wmetcalf/voiceover-switch-box/docs/button-card.pdf

# VoiceOver Switch Box

What each control does in VoiceOver mode (the normal mode, for using the iPad).

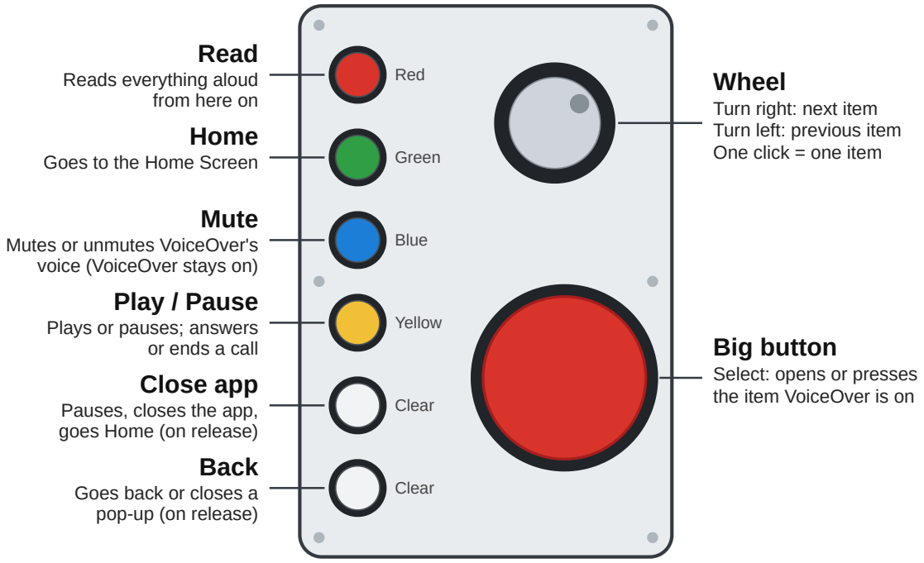
[picture p2: figure]
Read Reads everything aloud from here on; Red; Home; Goes to the Home Screen; Green; Mute Mutes or unmutes VoiceOver's voice (VoiceOver stays on); Blue; Play / Pause Plays or pauses; answers or ends a call; Yellow; Close app Pauses, closes the app, goes Home (on release); Clear; Back Goes back or closes a pop-up (on release); Wheel Turn right: next item Turn left: previous item One click = one item; Big button Select: opens or presses the item VoiceOver is on

Red button lit = box has power. Dark? Flip the USB-C plug at the box.

### Hold two buttons for 3 seconds

Hold
together

Does

Back + Close app (the two clear buttons) | Switches between VoiceOver mode and TD Snap mode. The box gives no sound or light when it switches.

Back +
Green

Turns VoiceOver's Quick Nav on or off. Rarely needed.

### Which mode is it in?

With VoiceOver on, turn the wheel.
VoiceOver moves from item to item = VoiceOver mode.
Nothing happens = TD Snap mode.
The box remembers its mode when unplugged.

### TD Snap mode (scanning)

Control | Does
Wheel, either way | Moves the highlight on
Big button | Chooses the highlighted item
Red | Moves the highlight on
Green | Chooses
Blue | Back
Yellow | iPad Home Screen
Close app (clear) | Next field (Tab)
Back (clear) | Back

If the wheel does nothing with VoiceOver on, the box is probably in TD Snap mode: hold the two clear buttons for 3 seconds. Firmware v10 · github.com/wmetcalf/voiceover-switch-box
