wmetcalf/voiceover-switch-box/hardware/pcb/voiceover_pcb_bom.csv

Qty | Refs | Value | Footprint
1 | BZ1 | Magnetic buzzer 3V, ~2.7kHz (or passive piezo) | Buzzer_Beeper:Buzzer_12x9.5RM7.6
2 | C1 C5 | 100nF | Capacitor_SMD:C_0805_2012Metric
1 | C2 | 10uF | Capacitor_SMD:C_0805_2012Metric
2 | C3 C4 | 4.7uF | Capacitor_SMD:C_0805_2012Metric
1 | D1 | 1N4148W | Diode_SMD:D_SOD-323
1 | D2 | B5819W | Diode_SMD:D_SOD-123
1 | D3 | Red - charging | LED_SMD:LED_0805_2012Metric
4 | H1 H2 H3 H4 | M3 | MountingHole:MountingHole_3.2mm_M3
1 | J1 | Pico 2 W pins 1-20 | Connector_PinSocket_2.54mm:PinSocket_1x20_P2.54mm_Vertical
1 | J2 | Pico 2 W pins 21-40 | Connector_PinSocket_2.54mm:PinSocket_1x20_P2.54mm_Vertical
1 | J3 | BTN Select 100mm | Connector_JST:JST_XH_B2B-XH-A_1x02_P2.50mm_Vertical
1 | J4 | BTN Red | Connector_JST:JST_XH_B2B-XH-A_1x02_P2.50mm_Vertical
1 | J5 | BTN Green | Connector_JST:JST_XH_B2B-XH-A_1x02_P2.50mm_Vertical
1 | J6 | BTN Blue | Connector_JST:JST_XH_B2B-XH-A_1x02_P2.50mm_Vertical
1 | J7 | BTN Yellow | Connector_JST:JST_XH_B2B-XH-A_1x02_P2.50mm_Vertical
1 | J8 | BTN Chooser | Connector_JST:JST_XH_B2B-XH-A_1x02_P2.50mm_Vertical
1 | J9 | BTN Back/Escape | Connector_JST:JST_XH_B2B-XH-A_1x02_P2.50mm_Vertical
1 | J10 | Encoder | Connector_JST:JST_XH_B4B-XH-A_1x04_P2.50mm_Vertical
1 | J11 | LiPo 1S (JST-PH) — check polarity! | Connector_JST:JST_PH_B2B-PH-K_1x02_P2.00mm_Vertical
1 | J12 | Power switch (panel SPST) | Connector_JST:JST_XH_B2B-XH-A_1x02_P2.50mm_Vertical
1 | J13 | RESET | Connector_PinHeader_2.54mm:PinHeader_1x02_P2.54mm_Vertical
1 | J14 | Red button LED (power light): 1 = LED + (VBUS), 2 = LED - (GND) | Connector_JST:JST_XH_B2B-XH-A_1x02_P2.50mm_Vertical
1 | JP1 | ENC VCC: A=3V3 (default) / B=VSYS | Jumper:SolderJumper-3_P1.3mm_Open_RoundedPad1.0x1.5mm
1 | Q1 | MMBT3904 | Package_TO_SOT_SMD:SOT-23
4 | R1 R3 R5 R8 | 1k | Resistor_SMD:R_0805_2012Metric
2 | R2 R4 | 2k DNP (fit only if ENC VCC=VSYS) | Resistor_SMD:R_0805_2012Metric
3 | R6 R9 R10 | 100k | Resistor_SMD:R_0805_2012Metric
1 | R7 | 4.7k (~210mA charge) | Resistor_SMD:R_0805_2012Metric
1 | U1 | MCP73831T-2ACI/OT | Package_TO_SOT_SMD:SOT-23-5
