wmetcalf/voiceover-switch-box/docs/build-guide.html

VoiceOver + TD Snap Adaptive Device

Complete Build Guide v10.11 — Dual-Mode · Raspberry Pi Pico 2 WH

🖶 PRINT WHOLE GUIDE

Prints every tab except the stencils, which have their own print buttons. Nothing happens? Open this page in Safari or Chrome.

① PARTS ② HOW IT WORKS ③ WIRING ③b PHYSICAL ③c WIRE STEPS ④ BUILD ⑤ FIRMWARE ⑥ iPHONE/iPAD ⑥b TD SNAP ⑦ LID STENCIL ⑦b SIDE STENCIL ⑧ PCB ⑨ TROUBLESHOOT

1Complete Parts List

01 — BRAIN

Raspberry Pi Pico 2 WH

Amazon B0DPF9N1MN (https://www.amazon.com/dp/B0DPF9N1MN)

~$10

02 — WHEEL

Adafruit 60mm CNC Rotary Encoder

adafruit.com — #5734

~$25

03 — SELECT BUTTON

Adafruit 100mm Arcade Button

adafruit.com — #1185 red or #1187 white

~$10

04 — RED MACRO

Adafruit 30mm LED Button — Red

adafruit.com — #3489

~$3

05 — GREEN MACRO

Adafruit 30mm LED Button — Green

adafruit.com — #3487

~$3

06 — BLUE MACRO

Adafruit 30mm LED Button — Blue

adafruit.com — #3490

~$3

07 — YELLOW MACRO

Adafruit 30mm LED Button — Yellow

adafruit.com — #3488

~$3

08 — CHOOSER + BACK

Adafruit 30mm LED Button — Clear ×2

adafruit.com — #3491

~$6

09 — SELECT WIRES

Quick-Connect Wires 0.187" (10-pack)

adafruit.com — #3835

~$5

10 — MACRO WIRES

Quick-Connect Wire Pairs 0.11" (10-pack)

adafruit.com — #1152 · 7 pairs used; a second pack if you light every button

~$5

11 — JUMPERS

ELEGOO Jumper Wire Kit (M-M and F-M)

Amazon B01EV70C78 (https://www.amazon.com/dp/B01EV70C78) (120-piece)

~$7

12 — BREADBOARD

400-Point Solderless Breadboard

Amazon B08Y59P6D1 (https://www.amazon.com/dp/B08Y59P6D1) (BOJACK kit, 830 + 400 point)

~$4

13 — BOX

LeMotech 263×182×95mm IP65 ABS Box (pale gray)

Amazon B0785ZBNKK (https://www.amazon.com/dp/B0785ZBNKK)

~$18

14 — HOLE SAW

HYCHIKA 19pc Hole Saw Kit, 19–152mm

Amazon B07Y1G2Y7K (https://www.amazon.com/dp/B07Y1G2Y7K) · the original box used its 44, 32 and 28mm saws; 22mm (filed out to 24) suits the USB-C port

~$20

15 — iPAD CABLE

USB-C to USB-C cable that carries data (USB-C iPads, iPhone 15+)

Lightning devices: Apple Lightning to USB Camera Adapter + USB-A to USB-C cable

~$6

16 — USB-C PANEL MOUNT

PENGLIN USB-C female-to-female panel-mount coupler, D-type (2-pack)

Amazon B0B4VWZD7X (https://www.amazon.com/dp/B0B4VWZD7X) · 24 mm hole, 2 screws; one spare. Passes power one way round only

~$8

17 — INTERNAL CABLE

Cable Matters braided USB-C to micro-USB cable, 1 m

Amazon B00UUBRX0Y (https://www.amazon.com/dp/B00UUBRX0Y) · panel mount → Pico, inside the box

owned

18 — SOLDER BOARD (optional)

Adafruit Perma-Proto half-size (#1609)

Same layout as the breadboard, soldered — see PCB tab

~$5

ESTIMATED TOTAL

~$143

!The Big Picture — What This Device Does

This device plugs into the iPad’s USB-C port (or pairs over Bluetooth). Once plugged in, it acts like a keyboard the iPad understands. When you turn the wheel or press a button, the device sends a keyboard signal to the iPhone/iPad telling VoiceOver (or TD Snap) what to do — exactly like if someone were swiping or tapping on the screen, but without needing fine motor control.

🎛

Wheel or Button

Student turns wheel or presses button

→

🟢

Pico (Brain)

Tiny computer converts it to a keyboard signal

→

📱

iPad

VoiceOver moves or activates

!What Each Control Does

The device has two modes. VoiceOver mode drives the iPhone/iPad screen reader. TD Snap mode drives the TD Snap communication app’s scanning. To switch, hold Back and Chooser together for 3 seconds (one button held alone never switches); the device remembers the mode after power-off. Back and Chooser act when released, so starting the two-button hold sends nothing.

Control | VoiceOver mode | Sends | TD Snap mode | Sends
Wheel, clockwise | Next item | VO + → | Advance scan | Space
Wheel, counter-clockwise | Previous item | VO + ← | Advance scan | Space
Big Select | Activate (= double-tap) | VO + Space | Select highlighted | Enter
● Red | Read from here | VO + A | Advance scan (spare) | Space
● Green | Home screen | VO + H | Select (spare) | Enter
● Blue | Mute / unmute VoiceOver speech (VoiceOver stays on) | VO + S | Back | Escape
● Yellow | Magic Tap (play/pause, answer/end call) | VO + Hyphen | iPad Home | Cmd + H
Chooser | Close the current app (on release): pause media, close the app, then Home | Media Pause · Cmd+W · Cmd+H | Next field | Tab
Back | Back / dismiss (on release) | Escape | Back | Escape
Back + Chooser — hold both 3 s | Switch to TD Snap mode | — | Switch to VoiceOver mode | —
Back + Green — hold both 3 s | Turn VoiceOver Quick Nav on/off (Green goes Home first) | ← + → together | Nothing extra (Green still selects) | —

VO = Control + Option.

How the device tells you what it’s doing:

- Power light: the Red button glows whenever the box has power. Dark when plugged in = flip the USB-C plug at the box end (the port only passes power one way round), or try another cable.
- Which mode? With VoiceOver on, turn the wheel. Moving from item to item = VoiceOver mode. Nothing happens = TD Snap mode.
- Mode switch (hold Back + Chooser together 3 s): the box gives no sound or light outside, so check with the wheel afterwards
- Pico’s LED (inside the box): on 1 s / off 1 s = VoiceOver, on ½ s / off ½ s = TD Snap, lit during every keystroke

!How to Read the Wiring Diagram

The wiring diagram in the WIRING tab looks technical, but it's really just a map showing where each wire plugs in. You don't need to understand electronics to use it — just match the wire colors and follow the labels.

The Yellow/Brown Board

This is the breadboard — a plastic block with holes in it. Wires just push into the holes. No tools, no glue. It's just a holder that keeps everything connected. You can pull wires out and move them if you make a mistake.

The Green Rectangle

This is the Pico — the tiny computer that runs everything. It sits on the breadboard. Inside the box a short cable runs from the Pico to the USB-C port on the side; the iPad’s cable plugs in there. That one cable also powers the device.

Row Numbers (1–30)

The holes on the breadboard are numbered 1–30 down the side. When a wire says "row 14", count down to hole number 14 from the top. Each row connects horizontally — so a wire in row 14 col A is connected to row 14 col B, C, D, E automatically inside the board.

Column Letters (a–j)

Each row has 10 holes labeled a through j across the top. The gap in the middle separates the two halves. The left half (a–e) is where the left side of the Pico sits. The right half (f–j) is where the right side sits.

The Red/Blue Strips (+ and −)

The red strip (+) carries 3.3V power. The blue strip (−) is ground. Think of them like the positive and negative of a battery. The encoder wheel needs both of these to power itself. All the button grounds connect to the blue (−) strip.

The Colored Lines

Each colored line is one wire. The color just helps you tell them apart — red means power, black means ground, yellow means encoder signal, purple means select button, and so on. The line shows where each end of the wire goes.

The most important rule: Each wire has two ends. One end goes to a Pico pin (shown in the diagram by the row and column). The other end goes to the button or encoder terminal. As long as both ends are in the right place, it works.

!What Each Wire Color Means

#### Red wire

Power (3.3V). Goes from the Pico's power pin to the encoder wheel's power terminal. The encoder needs this to work.

#### Black wire

Ground. Every component needs a ground wire to complete the circuit. Think of it as the return path for electricity.

#### Yellow wire (×2)

Encoder signals. These two wires tell the Pico which direction the wheel is turning and how fast. One wire = clockwise/counterclockwise, the other = how far.

#### Purple wire

Select button signal. When the big button is pressed, this wire carries a tiny signal to the Pico saying "activate now".

#### Red wire (macro)

Red button signal. Separate from the power red wire — this one connects the red macro button to the Pico.

#### Green wire

Green button signal. Connects the green macro button to the Pico.

#### Blue wire

Blue button signal. Connects the blue macro button to the Pico.

#### Yellow wire (macro)

Yellow button signal. Connects the yellow macro button to the Pico.

#### White wires (×2)

Chooser and Back button signals (the two clear buttons). Back’s is drawn dashed.

#### Pink-red wire

5 V from VBUS to the Red button’s light, the power indicator. Not 3.3 V.

3Breadboard Wiring Diagram

Encoder A/B (GP10/11)

Select (GP15)

Red (GP16) / 3.3V

Green (GP17)

Blue (GP18)

Yellow (GP19)

Chooser / Back (GP20/21)

Red LED power light (VBUS 5 V)

GND

!Complete Wire Reference

COLOR | FROM (Pico pin) | TO | CONNECTOR
Red | 3.3V — right + rail | Encoder VCC screw terminal | M-M jumper
Black | GND — left − rail | Encoder GND screw terminal | M-M jumper
Yellow | GP10 — left col e, row 14 | Encoder A screw terminal | M-M jumper
Yellow (dashed) | GP11 — left col e, row 15 | Encoder B screw terminal | M-M jumper
Purple | GP15 — left col e, row 20 | Select button terminal 1 | M-M + 0.187" pair
Black | GND rail, any row | Select button terminal 2 | M-M + 0.187" pair
Red | GP16 — right col f, row 20 | Red button signal | M-M + 0.11" pair
Green | GP17 — right col f, row 19 | Green button signal | M-M + 0.11" pair
Blue | GP18 — right col f, row 17 | Blue button signal | M-M + 0.11" pair
Yellow | GP19 — right col f, row 16 | Yellow button signal | M-M + 0.11" pair
White | GP20 — right col f, row 15 | Chooser (clear) button signal | M-M + 0.11" pair
White (dashed) | GP21 — right col f, row 14 | Back (clear) button signal | M-M + 0.11" pair
Black ×6 | GND rail, any row | Each 30 mm button GND terminal | M-M + 0.11" pair
Pink-red | VBUS (5 V) — right side, row 1 | Red button LED + tab (power light) | M-M + 0.11" pair
Black | GND rail, any row | Red button LED − tab | M-M + 0.11" pair
USB cable | Pico micro-USB | USB-C panel port on the box, then iPad | Internal USB-C to micro-USB cable

Button wires: each Adafruit quick-connect pair has two spade clips joined in a 2-pin plug. Push the clips onto the button’s two terminals and two M-M jumpers into the plug, one to the signal row and one to the − rail. All button GND wires and the Red LED − tap off the minus rails. The Red LED + goes to VBUS (row 1 right, 5 V), never the + rail: the button LEDs need 5 V. A bridge wire at row 28 connects left and right minus rails so GND is available on both sides.

!Physical Wiring Reference

Pico 2 WH on 400-point breadboard. USB port faces UP toward row 1. Left pins in col e, right pins in col f. 4 free columns on each side (a-d left, g-j right).

Pin / Row | GPIO | Connects to | Wire
Row 3 right | GND | Right − rail | Short black M-M
Row 5 right | 3V3 | Right + rail | Short red M-M
− rail bridge | — | Left − → Right − | Long black M-M (row 28)
Right + rail | — | Encoder VCC screw terminal | Red M-M jumper
Left − rail | — | Encoder GND screw terminal | Black M-M jumper
Row 14 left | GP10 | Encoder A screw terminal | Yellow M-M
Row 15 left | GP11 | Encoder B screw terminal | Yellow M-M
Row 20 left | GP15 | Select button signal | Purple + 0.187" pair
Left − rail | — | Select button GND | Black + 0.187" pair
Macro buttons (right side, 0.11" pairs) — skip row 18!
Row 20 right | GP16 | ⬤ Red button signal | Red M-M + 0.11" pair
Row 19 right | GP17 | ⬤ Green button signal | Green M-M + 0.11" pair
Row 17 right | GP18 | ⬤ Blue button signal | Blue M-M + 0.11" pair
Row 16 right | GP19 | ⬤ Yellow button signal | Yellow M-M + 0.11" pair
Row 15 right | GP20 | Chooser button signal | M-M + 0.11" pair
Row 14 right | GP21 | Back button signal (hold with Chooser 3 s = switch mode) | M-M + 0.11" pair
v10 additions
Row 1 right | VBUS | Red button LED + (power light). LED − → − rail | 0.11" quick-connect; 5 V, never the + rail
Left − rail ×6 | — | Each macro button GND | 6× black + 0.11" pair

Row 18 right = GND — skip it! Jump from row 19 (Green) directly to row 17 (Blue). No wire for row 18.

Encoder terminals: loosen each screw, insert a jumper’s pin, tighten. Go by the labels printed beside the terminals (VCC or +, GND or 0V, A, B); leave any others unused.

!Step-by-Step Wiring — One Wire at a Time

14 steps with diagrams. Each step shows exactly which row and column.

Step 1 of 140%

← Back Next →

4Physical Construction

1

### Print the drill stencil

Go to the LID STENCIL tab and click PRINT THIS STENCIL. Letter or A4, Landscape, scale 100% — do NOT fit to page. Verify the 100mm scale bar measures exactly 100mm with a ruler before drilling.

2

### Tape stencil and center punch

Cut along dashed border and tape firmly to the box lid. Tap a nail or center punch on each crosshair mark to make a small dent — stops the drill from walking.

3

### Drill the holes

- Encoder center — 44mm (the kit’s 1¾" saw)
- Encoder M3 screws (×3) — 3.5mm drill bit
- Select button — 28mm (the kit’s 1⅛" saw; the 24mm thread goes through and the dome covers the hole)
- 6× 30mm buttons — 32mm (the kit’s 1¼" saw). Adafruit asks for about 30mm; 32mm is what the original box used, and the flange still covers it.
- USB-C panel mount (side panel) — 24mm: the kit’s 22mm saw, then file out to fit (or a step drill), + 3.5mm drill bit (×2 flange screws). Don’t go bigger: the flange is only a little wider.

Pilot holes: Drill a 6–8mm pilot through every hole saw center mark first — stops the saw from wandering and prevents cracking the ABS. Use the crosshair on the stencil. Go slow — ABS melts if you push hard. Deburr edges after.

Clamp the lid before drilling. ABS grabs the bit at breakthrough.

4

### Mount USB-C panel connector on side panel

Print the SIDE STENCIL: centered on the 182 mm face, 20 mm from the bottom. Cut the 24 mm hole, then hold the D-type coupler in place and drill a 3.5 mm hole through each of its two flange holes (they sit on opposite corners). Plug the USB-C end of the internal cable into the coupler’s inside socket and the micro-USB end into the Pico.

5

### Mount encoder wheel

Drop it into the hole from above, face on the lid. Fix it with three M3 screws through the holes you marked (nuts underneath if its holes aren’t threaded). Connect M-M jumper wires by inserting a pin into each screw terminal and tightening the screw.

6

### Mount 100mm select button

Insert from above, tighten ring from below. Clip 0.187" quick-connect wires onto the two spade terminals on the internal microswitch.

7

### Mount the six 30mm buttons in a row

Insert each 30mm button, tighten ring from below. Clip 0.11" wires onto the switch terminals, and onto the Red button’s two LED tabs (the power light). With the box standing upright the row becomes the left-hand column, Red at the top.

Order: Red (GP16) · Green (GP17) · Blue (GP18) · Yellow (GP19) · Chooser (GP20, clear) · Back (GP21, clear)

8

### Wire the breadboard

Pico on breadboard straddling center gap, USB port facing out. Wire all connections per the WIRING tab.

9

### TEST before closing the box

Plug the iPad in and test the wheel, the select button and all six buttons. The Red button should light. Fix issues now while the lid is off.

Everything working? Close the box.

Do not close until all buttons work.

10

### Close and finish

Tighten the lid screws. Add rubber feet to bottom corners.

6iPhone / iPad Setup — VoiceOver Mode

Do this once on the student’s iPad. Using the TD Snap app? Do this tab first (the student still needs VoiceOver to get around), then the TD SNAP tab.

Cable: the box has a USB-C port. USB-C iPads and iPhone 15 and later → a USB-C to USB-C cable that carries data (many are charge-only). iPhone 14 and earlier → Apple’s Lightning to USB Camera Adapter plus a USB-A to USB-C cable. Not needed for Bluetooth.
One way round: the box’s USB-C port only passes power with the plug one way up. The Red button lights when it’s right. Best: leave the cable plugged into the box and unplug it only at the iPad, whose port works either way.

1

### Turn on VoiceOver and set the triple-click shortcut

Settings → Accessibility → VoiceOver → ON, then Settings → Accessibility → Accessibility Shortcut → VoiceOver.

The box can’t turn VoiceOver off, so a blind user can’t strand themselves. A caregiver toggles it by triple-clicking the side or top button.

2

### Check VoiceOver’s modifier keys

Settings → Accessibility → VoiceOver → Typing → Modifier Keys must include Control + Option. Every VoiceOver command from the box uses it.

3

### Turn OFF Full Keyboard Access

Settings → Accessibility → Keyboards & Typing → Full Keyboard Access → OFF

If it’s on, it grabs the keystrokes before VoiceOver sees them and the buttons appear dead.

4

### Connect the device

- Allow the accessory. On iPadOS 26: Settings → Privacy & Security → Wired Accessories → Always Allow or Automatically Allow When Unlocked. If the iPad was locked when the box was plugged in, unplug it, unlock the iPad, and plug it in again.
- USB: plug it in. The Red button lights when the box has power; if it stays dark, flip the plug at the box end. If iOS says the accessory needs keyboard setup, tap Dismiss.
- Keyboard layout: U.S. Settings → General → Keyboard → Hardware Keyboard. Other layouts move the letter keys the box relies on.
- Bluetooth (optional): power the device, then Settings → Bluetooth and tap VoiceOver Device. One-time pairing. When USB is plugged in, the box sends over USB only, so nothing is typed twice.

5

### Turn off the things that surprise the student

- Picture in Picture: Settings → General → Picture in Picture → Start PiP Automatically → OFF. Otherwise, going Home from Netflix or Apple TV during a video keeps it playing in a floating window.
- Dictation shortcut: if Settings → General → Keyboard offers a “press Control twice” Dictation shortcut, turn it off. Current firmware avoids triggering it, but there’s no reason to leave it on.
- Home Screen: keep the student’s apps on the first page or in the dock. The box has no button for changing pages; pressing Green (Home) again on the Home Screen goes back to the first page.
- Notifications: turn on a Focus / Do Not Disturb mode during games and videos so alerts don’t interrupt.

6

### Check the mode

With VoiceOver on, turn the wheel. If VoiceOver moves from item to item, the box is in VoiceOver mode. If nothing happens it is in TD Snap mode — hold Back and Chooser together for 3 seconds to switch. (With the lid off, the Pico’s LED also shows it: on 1 s / off 1 s = VoiceOver, twice as fast = TD Snap.)

7

### Quick Nav doesn’t matter

The box sends Control + Option commands, which work whether Quick Nav is on or off. If you want to change it anyway, hold Back and Green together for 3 seconds; VoiceOver says “Quick Nav on” or “off”.

8

### Watching games and videos

- Blue mutes VoiceOver; press it again to bring the voice back. VoiceOver stays on, so the student can unmute it themselves.
- While muted, the wheel still moves VoiceOver’s focus silently — unmute before navigating.
- Yellow plays or pauses. Chooser pauses, closes the app and goes Home.

9

### Try it

Turn the wheel — VoiceOver should speak each item. Press the big button to open it.

Control | Does | Sends
Wheel, clockwise | Next item | VO + →
Wheel, counter-clockwise | Previous item | VO + ←
Big Select | Activate (= double-tap) | VO + Space
● Red | Read from here | VO + A
● Green | Home screen | VO + H
● Blue | Mute / unmute VoiceOver speech (VoiceOver stays on) | VO + S
● Yellow | Magic Tap (play/pause, answer/end call) | VO + Hyphen
Chooser | Close the current app (on release): pause media, close the app, then Home | Media Pause · Cmd+W · Cmd+H
Back | Back / dismiss (on release) | Escape
Back + Chooser — hold both 3 s | Switch to TD Snap mode | —
Back + Green — hold both 3 s | Turn VoiceOver Quick Nav on/off (Green goes Home first) | ← + → together

6bTD Snap Mode — iPad Setup

TD Snap (Tobii Dynavox) is an AAC app: the student picks words and phrases and TD Snap speaks them. Its own scanning access method moves a highlight across the buttons; it takes Space as “move the highlight” and Enter as “choose this”. In TD Snap mode the device sends exactly those keys.

For a student who is blind and non-speaking, VoiceOver gets them around the iPad and into TD Snap; TD Snap’s Audio Feedback (step 3) tells them what the scan highlight is on. Both matter.

1

### Switch the device to TD Snap mode

Hold Back and Chooser together for 3 seconds. The box gives no sound or light when it switches. The mode is remembered after power-off. Do the same again to return to VoiceOver mode.

Switch back to VoiceOver mode before using VoiceOver. In TD Snap mode the wheel sends Space, which VoiceOver ignores, so the box looks broken: the wheel does nothing and only Chooser (Tab) seems to work.

2

### Configure TD Snap scanning

In TD Snap, open Edit, then User → Access Method:

1. Access Method: Scanning
2. Scan Type: 2 Switch Step Scan
3. Switch 1 (Next): Space · Switch 2 (Select): Enter
4. Tap Done

Don’t use 1 Switch Auto Scan with Enter as the switch — Tobii Dynavox documents that it stops responding after you leave the app. The device is built for 2 Switch Step Scan.

The Scanning page set is organised for efficient scanning; other page sets work but scan more slowly.

3

### Turn on Audio Feedback — essential for this student

Same screen (User → Access Method): Audio Feedback → ON. Pick a voice that is different from the student’s speaking voice, so they can tell “what the highlight is on” from “what I’m saying”.

If the student has some vision, also try Zoom and a high-contrast highlight.

4

### VoiceOver and TD Snap together — test this first

Not yet verified: whether TD Snap still receives Space/Enter while VoiceOver is on. Test it:

1. VoiceOver on. Open TD Snap. Put the device in TD Snap mode.
2. Turn the wheel one click.
3. Highlight moves and Audio Feedback speaks → leave VoiceOver on. Simplest setup.
4. Nothing happens, or VoiceOver talks over it → a caregiver triple-clicks to turn VoiceOver off while in TD Snap, and back on when leaving.

Either way: Full Keyboard Access and Switch Control stay OFF.

5

### Button map in TD Snap mode

Control | Does | Sends
Wheel, clockwise | Advance scan | Space
Wheel, counter-clockwise | Advance scan | Space
Big Select | Select highlighted | Enter
● Red | Advance scan (spare) | Space
● Green | Select (spare) | Enter
● Blue | Back | Escape
● Yellow | iPad Home | Cmd + H
Chooser | Next field | Tab
Back | Back | Escape
Back + Chooser — hold both 3 s | Switch to VoiceOver mode | —
Back + Green — hold both 3 s | Nothing extra (Green still selects) | —

6

### Guided Access — probably not for this student

Guided Access locks the iPad to TD Snap. That blocks the student from leaving TD Snap to use VoiceOver elsewhere, so only use it for sessions where TD Snap is the only activity: Settings → Accessibility → Guided Access, set a passcode, open TD Snap, triple-click, Start.

!Firmware — v10.11

v10 changes: VoiceOver commands no longer depend on Quick Nav · USB or Bluetooth, never both · encoder read by interrupt, one step per click · debounce plus adjustable hold time and ignore-repeat · two-button mode switch · Red no longer turns VoiceOver off; Blue mutes/unmutes VoiceOver (v10.1) · wheel stops when the hand stops (v10.2) · USB never freezes, wakes a sleeping iPad, reboots itself if it ever hangs (v10.3) · mode switch needs Back + Chooser held together, so one long press can’t change modes; USB serial test port (v10.4) · key combinations typed like a person, timed from when the iPad picks them up, so iPad VoiceOver accepts them (v10.5) · fast wheel spins no longer open Dictation (v10.6) · Chooser changes Home Screen page: press = next, hold 1 s = previous (v10.7) · Back + Green held 3 s toggles VoiceOver Quick Nav (v10.8) · Chooser closes the current app instead of turning pages (v10.9); pauses video first so it doesn’t go to Picture in Picture (v10.10) · optional battery monitor. Compiles cleanly against arduino-pico 6.3.0 (Pico 2 W, IPv4 + Bluetooth) and passes 44 simulated scenarios (wheel, buttons, debounce, two-button mode switch, key-combination timing including a slow-polling iPad, Control never pressed alone, USB/Bluetooth routing, USB stall and sleep, watchdog, serial test port).

⚡

### Quickest: install the ready-made firmware (no Arduino needed)

This installs firmware v10.11 with the default settings. Use the Arduino steps below only if you need to change settings.

⬇ DOWNLOAD voiceover_device_ble.uf2

1. Unplug the Pico. Hold its white BOOTSEL button, plug the USB cable into the computer, then let go.
2. A drive named RP2350 appears.
3. Drag voiceover_device_ble.uf2 onto it. The drive disappears and the Pico restarts (its LED flashes 3 times).

Mac: a “Disk Not Ejected Properly” message afterwards is normal. If Finder refuses the copy, use Terminal: cp -X ~/Downloads/voiceover_device_ble.uf2 /Volumes/RP2350/ (or rsync ~/Downloads/voiceover_device_ble.uf2 /Volumes/RP2350/).

Windows: drag it onto the RP2350 drive in File Explorer.

A

### Install Arduino IDE

Download Arduino IDE 2 from arduino.cc. Mac: drag it into Applications. Windows: use the EXE installer, not the Microsoft Store version (it has USB detection issues).

B

### Add the Earle Philhower board package

File → Preferences → Additional Board Manager URLs → add:

https://github.com/earlephilhower/arduino-pico/releases/download/global/package_rp2040_index.json

Then Tools → Board → Boards Manager → search pico → install Raspberry Pi Pico/RP2040/RP2350 by Earle F. Philhower III.

C

### Select the correct board

Tools → Board → Raspberry Pi RP2040/RP2350 → Raspberry Pi Pico 2 W

D

### Enable Bluetooth — CRITICAL

Tools → IP/Bluetooth Stack → IPv4 + Bluetooth. Leave Tools → USB Stack on Pico SDK.

Nothing will work without this. The Bluetooth libraries won’t compile unless this is set.

E

### Download and upload the sketch

Click the download button below to get the .ino file. Open it in Arduino IDE. Then:

1. Hold BOOTSEL button on the Pico
2. Plug USB into your PC while holding BOOTSEL
3. Release BOOTSEL — a drive called RP2350 appears
4. Click Upload in Arduino IDE
5. Wait ~30 seconds for "Done uploading"
6. Later updates don’t need BOOTSEL: pick the Pico’s port and click Upload. The box’s USB-C port works for this too (right way up).

LED flashes 3 times — firmware is running in VoiceOver mode.

F

### Tuning for the student

All settings are at the top of the sketch. Change, re-upload.

- COUNTS_PER_STEP — 4 = one step per wheel click, 8 = one step per two clicks.
- HOLD_MS — a press must last this long to count. Filters brushes and tremor. Try 100–300.
- IGNORE_REPEAT_MS — ignores a second press of the same button within this window. Filters double-hits. Try 300–800.
- MODE_HOLD_MS — how long to hold Back + Chooser together to switch modes (default 3000).
- ENC_MAX_PENDING — how many wheel steps can queue up when the wheel is spun fast (default 3). Lower = stops sooner.
- ENC_REVERSE, BATT_SENSE_ENABLED (PCB with battery only).

Set these with the student’s OT — they’re the same ideas as iOS Switch Control’s Hold Duration and Ignore Repeat.

G

### Bluetooth name

The sketch passes the name to KeyboardBLE.begin("VoiceOver Device"). The library only falls back to “PicoW BLE Keyboard” when no name is passed, so no library patch is needed — the v8/v9 patcher script was unnecessary.

If the iPad still shows the old name, iOS is showing a cached name for this device. On the iPad: Settings → Bluetooth → (i) → Forget This Device, turn Bluetooth off, power-cycle the device, turn Bluetooth on, pair again.

To see what the device is actually advertising, scan with the free nRF Connect app on a phone that has never paired with it.

⬇ DOWNLOAD voiceover_device_ble.ino

/*
 * ═══════════════════════════════════════════════════════════════════
 * VoiceOver + TD Snap Adaptive Device — firmware v10.11
 * Raspberry Pi Pico 2 W · Earle Philhower arduino-pico core
 *
 *   Board: Raspberry Pi Pico 2 W
 *   Tools > IP/Bluetooth Stack > IPv4 + Bluetooth      <- REQUIRED
 *   Tools > USB Stack > Pico SDK (the default)
 *
 * Changes from v9
 *   • VoiceOver mode sends VO-prefixed commands (Ctrl+Option+…), so it
 *     works whether Quick Nav is on or off. Quick Nav no longer matters.
 *   • Keys go to USB when a host is connected, otherwise to BLE —
 *     never both (v9 double-typed when USB and BLE hit the same iPad).
 *   • Encoder decoded by interrupt (x4); key output is non-blocking, so
 *     fast wheel turns no longer drop pulses.
 *   • One wheel click = one step (v9 stepped every 1.5 clicks).
 *   • Debounce on every input, plus optional hold time / ignore-repeat
 *     for users with tremor.
 *   • Audio feedback through an optional piezo (silent if not fitted).
 *   • Mode switch: hold BACK + CHOOSER together for 3 s (v10.4; was BACK
 *     alone, which was too easy to trigger by accident). No re-plugging.
 *   • Red no longer turns VoiceOver off (a stranding risk for a blind user).
 *   • v10.1: Blue mutes/unmutes VoiceOver speech (VO+S) so it stays quiet
 *     during videos and games; VoiceOver stays on, the same button brings it back.
 *   • v10.2: wheel steps no longer pile up when spun fast. At most
 *     ENC_MAX_PENDING steps are buffered, and turning back cancels pending
 *     forward steps (VoiceOver mode), so the focus stops when the hand stops.
 *   • v10.3: USB never freezes the firmware. If the host is connected but
 *     not reading the keyboard, keys go over Bluetooth after 50 ms instead
 *     of stalling ~2 s per press. A sleeping host gets a USB wake-up request.
 *     8 s watchdog: if anything ever hangs, the device reboots itself.
 *   • v10.4: mode switch needs BACK + CHOOSER held together for 3 s, so a long
 *     press on one button can't silently change modes. BACK and CHOOSER now act
 *     on release (so starting the two-button hold sends nothing). USB serial
 *     test port: a computer can press buttons and read status (see SERIAL TEST).
 *   • v10.5: key combinations are typed like a person types them: Control +
 *     Option go down 40 ms before the key, the key is held 60 ms, and the
 *     modifiers come up after the key (v10.4 sent them all within a few ms).
 *     Hold times now start when the host has taken each report, so an iPad
 *     that polls slowly still sees the full 60 ms (it measured 1-3 ms on v10.4).
 *   • v10.6: spinning the wheel fast no longer opens Dictation on the iPad.
 *     Option goes down before Control, so Control is never pressed alone, and
 *     Control+Option stay held through a fast spin instead of tapping per step.
 *   • v10.7: in VoiceOver mode CHOOSER changes Home Screen page instead of
 *     opening the item chooser: press = next page (Option+→), hold 1 s =
 *     previous page (Option+←, a tick sounds at 1 s). Needs VoiceOver Quick
 *     Nav on (the iPad default). TD Snap mode is unchanged (Tab).
 *   • v10.8: hold BACK + GREEN for 3 s to toggle VoiceOver Quick Nav (sends
 *     Left + Right arrow together; VoiceOver says "Quick Nav on/off"). Chooser's
 *     page turning only works with Quick Nav on.
 *   • v10.9: in VoiceOver mode CHOOSER closes the current app: Home, then
 *     Cmd+Tab / Cmd+Q in the app switcher, Cmd+Esc, Home (replaces the v10.7
 *     page turning). TD Snap mode is unchanged (Tab).
 *   • v10.10: CHOOSER close-app sends media Pause first, then Cmd+W, then Home,
 *     so a playing video isn't pushed into Picture in Picture (v10.9 went Home
 *     first, which started PiP, and its app-switcher quit didn't take).
 *   • v10.11: clean-up, no change in behaviour. Removed the four unused spare
 *     inputs on GP2–GP5 and the actions no button used any more (item chooser,
 *     page turning, a bare Control tap).
 *   • Optional battery monitoring with low-battery beeps.
 *
 * Everything you are likely to tune is in the SETTINGS block below.
 * ═══════════════════════════════════════════════════════════════════
 */

#include <Keyboard.h>
#include <KeyboardBLE.h>
#include <EEPROM.h>
#include <PicoBluetoothBLEHID.h>    // .connected() for the status report

#include <USB.h>                      // USB.mutex (arduino-pico core)

extern "C" {                          // TinyUSB device API
  bool tud_mounted(void);             // a USB host has enumerated us
  bool tud_suspended(void);           // host has put the bus to sleep
  bool tud_remote_wakeup(void);       // ask a sleeping host to wake
  bool tud_hid_n_ready(uint8_t inst); // keyboard endpoint free (host is reading it)
}

// ═══════════════════════════ SETTINGS ═════════════════════════════

// BLE name shown in iPhone/iPad Bluetooth settings.
// iOS caches the name of a device it has seen before; after changing it,
// Forget the device, toggle Bluetooth off/on, and re-pair.
#define BLE_NAME            "VoiceOver Device"
#define FW_VERSION          "v10.11"

// Wheel: quadrature counts per navigation step.
// The 60 mm encoder has 100 detents/rev and gives 4 counts per detent.
// 4 = one step per click, 8 = one step per two clicks.
#define COUNTS_PER_STEP     4
#define ENC_REVERSE         false   // true if clockwise moves backwards
#define ENC_MAX_PENDING     3       // max wheel steps buffered; extra spin is dropped

// Input timing — tune these with the student's OT.
#define DEBOUNCE_MS         25      // contact bounce filter (leave alone)
#define HOLD_MS             0       // press must last this long to count (0 = instant)
#define IGNORE_REPEAT_MS    0       // ignore re-presses of the same input within this window
#define MODE_HOLD_MS        3000    // hold BACK + CHOOSER together this long to switch mode

// Audio feedback (needs piezo on GP22; harmless if absent)
#define AUDIO_ENABLED       true
#define CLICK_ON_ACTION     false   // short tick on every action

// Battery sense (PCB with LiPo + 100k/100k divider on GP26 only)
#define BATT_SENSE_ENABLED  false
#define BATT_LOW_V          3.50f

// ═══════════════════════════ PINS ═════════════════════════════════
// Breadboard prototype pins are unchanged from v9.
#define ENC_A      10   // pin 14
#define ENC_B      11   // pin 15
#define SEL_PIN    15   // pin 20  big select button
#define RED_PIN    16   // pin 21
#define GRN_PIN    17   // pin 22
#define BLU_PIN    18   // pin 24
#define YLW_PIN    19   // pin 25
#define CHO_PIN    20   // pin 26  "Chooser"
#define BACK_PIN   21   // pin 27  Back (hold with CHOOSER 3 s = switch mode)
#define PIEZO_PIN  22   // pin 29  (optional)
#define BATT_PIN   26   // pin 31  ADC0 (optional)

// ═══════════════════════════ ACTIONS ══════════════════════════════
enum Action : uint8_t {
  A_NONE, A_NEXT, A_PREV, A_SELECT, A_BACK, A_HOME,
  A_READ, A_MAGIC, A_TAB, A_MUTE, A_CLOSE_APP
};

enum Mode : uint8_t { MODE_VOICEOVER = 0, MODE_TDSNAP = 1 };

// Input order used by the tables below
enum InputIdx : uint8_t {
  IN_SEL, IN_RED, IN_GRN, IN_BLU, IN_YLW, IN_CHO, IN_BACK, NUM_INPUTS
};

const uint8_t INPUT_PINS[NUM_INPUTS] = {
  SEL_PIN, RED_PIN, GRN_PIN, BLU_PIN, YLW_PIN, CHO_PIN, BACK_PIN
};

// What each input does in each mode.
const Action INPUT_ACTION[2][NUM_INPUTS] = {
  // VoiceOver mode
  { A_SELECT,   // big select    VO+Space    activate item
    A_READ,     // red           VO+A        read from here
    A_HOME,     // green         VO+H        Home screen
    A_MUTE,     // blue          VO+S        mute/unmute VoiceOver speech (for videos)
    A_MAGIC,    // yellow        VO+Hyphen   Magic Tap (play/pause, answer call)
    A_CLOSE_APP,// chooser       close the current app: media Pause, Cmd+W, Cmd+H
    A_BACK },   // back          Escape
  // TD Snap mode (TD Snap: Scanning, 2 Switch Step Scan, Space = next, Enter = select)
  { A_SELECT,   // big select    Enter
    A_NEXT,     // red           Space (spare next)
    A_SELECT,   // green         Enter (spare select)
    A_BACK,     // blue          Escape
    A_HOME,     // yellow        Cmd+H  (iPad Home)
    A_TAB,      // chooser       Tab
    A_BACK }    // back          Escape
};

// ═══════════════════════════ STATE ════════════════════════════════
Mode currentMode = MODE_VOICEOVER;
#define EEPROM_MODE_ADDR  0
#define EEPROM_MAGIC_ADDR 1
#define EEPROM_MAGIC      0xA5

struct Btn {
  bool     raw, stable;
  uint32_t rawChangedAt, pressedAt, lastFireAt;
  bool     fired, suppressed;    // suppressed: used in the mode-switch hold, don't act on release
};
Btn btn[NUM_INPUTS];

// ═══════════════════════════ ENCODER (interrupt, x4) ══════════════
volatile int32_t encCount = 0;
int32_t encPending = 0;            // wheel steps waiting to be sent (+ next, - prev)
volatile uint8_t encState = 0;
static const int8_t QDEC[16] = { 0,-1, 1, 0,  1, 0, 0,-1,  -1, 0, 0, 1,  0, 1,-1, 0 };

void encISR() {
  uint8_t s = (digitalRead(ENC_A) << 1) | digitalRead(ENC_B);
  encState = ((encState << 2) | s) & 0x0F;
  encCount += QDEC[encState];
}

// ═══════════════════════════ KEY OUTPUT (non-blocking) ════════════
// Each event is a chord of up to 4 keys. A chord is typed the way a person
// types it: modifiers down first, then the key, key up, then modifiers up.
#define MOD_LEAD_MS  40     // modifiers held this long before the key goes down
#define KEY_HOLD_MS  60     // key held down
#define MOD_TAIL_MS  20     // modifiers held this long after the key comes up
#define MOD_BRIDGE_MS 150   // keep Control+Option down this long for a following wheel step
#define KEY_GAP_MS   20     // quiet time before the next chord
#define QLEN         16
#define USB_READY_WAIT_MS  50   // host connected but not reading keys: give up on USB after this
#define USB_WAKE_WAIT_MS   300  // host asleep: wait this long for it to wake before using BLE

struct KeyEvt { uint8_t k[4]; uint8_t n; uint16_t wait; bool keep; uint16_t cons; };  // wait: ms of quiet before it; keep: tap under the previous modifiers; cons: media key (consumer usage) instead of keys
KeyEvt   keyQ[QLEN];
uint8_t  qHead = 0, qTail = 0;
enum { K_IDLE, K_MODS, K_DOWN, K_HOLDMODS, K_GAP } kState = K_IDLE;
uint32_t kSince = 0;
bool     kOnUSB = false;
KeyEvt   kCur;                                  // chord being typed

bool queueKeysEx(uint16_t wait, bool keep, uint8_t a, uint8_t b = 0, uint8_t c = 0, uint8_t d = 0) {
  uint8_t next = (qTail + 1) % QLEN;
  if (next == qHead) return false;            // full: drop (e.g. wheel spun very fast)
  KeyEvt &e = keyQ[qTail];
  e.n = 0; e.wait = wait; e.keep = keep; e.cons = 0;
  if (a) e.k[e.n++] = a;
  if (b) e.k[e.n++] = b;
  if (c) e.k[e.n++] = c;
  if (d) e.k[e.n++] = d;
  qTail = next;
  return true;
}
bool queueKeys(uint8_t a, uint8_t b = 0, uint8_t c = 0, uint8_t d = 0) { return queueKeysEx(0, false, a, b, c, d); }
bool queueMedia(uint16_t wait, uint16_t usage) {     // consumer-page key, e.g. 0x00B1 Pause
  uint8_t next = (qTail + 1) % QLEN;
  if (next == qHead) return false;
  KeyEvt &e = keyQ[qTail];
  e.n = 0; e.wait = wait; e.keep = false; e.cons = usage;
  qTail = next;
  return true;
}

// Where should the next keystroke go?  USB if a host is connected AND reading
// the keyboard; otherwise Bluetooth.  Never blocks: returns 0 to "try again
// next loop" while waiting for the host to become ready or to wake up.
// (The core's own send waits up to 500 ms per report when the host isn't
// reading, which froze v10.2 for ~2 s per press.)
uint32_t usbWaitSince = 0;
bool     usbWakeSent  = false;

bool usbHidReady() {
  CoreMutex m(&USB.mutex, false);
  return m && tud_hid_n_ready(0);
}

void usbWakeup() {
  CoreMutex m(&USB.mutex, false);
  if (m) tud_remote_wakeup();
}

uint8_t pickTransport(uint32_t now) {
  if (!tud_mounted()) { usbWaitSince = 0; usbWakeSent = false; return 2; }
  if (usbWaitSince == 0) usbWaitSince = now ? now : 1;
  if (tud_suspended()) {                                 // host asleep (e.g. iPad screen off)
    if (!usbWakeSent) { usbWakeup(); usbWakeSent = true; }
    if (now - usbWaitSince < USB_WAKE_WAIT_MS) return 0;
  } else if (usbHidReady()) {
    usbWaitSince = 0; usbWakeSent = false; return 1;     // normal case
  } else if (now - usbWaitSince < USB_READY_WAIT_MS) {
    return 0;                                            // previous report still in flight
  }
  usbWaitSince = 0; usbWakeSent = false; return 2;       // USB not usable for this key
}

// Does the next queued chord use the same modifiers as the one being typed?
bool nextHasSameMods() {
  const KeyEvt &a = keyQ[qHead];
  if (a.n != kCur.n || a.n < 2) return false;
  for (uint8_t i = 0; i + 1 < a.n; i++) if (a.k[i] != kCur.k[i]) return false;
  return true;
}

void kPress(uint8_t k)   { if (kOnUSB) Keyboard.press(k);   else KeyboardBLE.press(k); }
void kRelease(uint8_t k) { if (kOnUSB) Keyboard.release(k); else KeyboardBLE.release(k); }
void kReleaseAll()       { if (kOnUSB) Keyboard.releaseAll(); else KeyboardBLE.releaseAll(); }

// Times are counted from when the host has actually TAKEN the last report,
// not from when we queued it. An iPad that polls the keyboard slowly saw
// v10.4's 30 ms key hold shrink to 1-3 ms. Give up waiting after
// USB_READY_WAIT_MS so a host that stops reading can't stall us.
uint32_t kQueuedAt = 0;
bool     kTiming   = false;
void kEnter(int st, uint32_t now) { kState = (decltype(kState))st; kQueuedAt = now; kTiming = false; }
bool kHeld(uint32_t now, uint32_t ms) {
  if (!kTiming) {
    if (kOnUSB && !usbHidReady() && now - kQueuedAt < USB_READY_WAIT_MS) return false;
    kTiming = true; kSince = now;
  }
  return now - kSince >= ms;
}

void serviceKeys(uint32_t now) {
  switch (kState) {
    case K_IDLE:
      if (qHead != qTail) {
        uint8_t t = pickTransport(now);       // 0 = wait, 1 = USB, 2 = BLE
        if (t == 0) break;
        kOnUSB = (t == 1);
        kCur = keyQ[qHead];
        qHead = (qHead + 1) % QLEN;
        digitalWrite(LED_BUILTIN, HIGH);
        if (kCur.cons) {                      // media key
          if (kOnUSB) Keyboard.consumerPress(kCur.cons); else KeyboardBLE.consumerPress(kCur.cons);
          kEnter(K_DOWN, now);
        } else if (kCur.n > 1) {              // modifiers first
          for (uint8_t i = 0; i + 1 < kCur.n; i++) kPress(kCur.k[i]);
          kEnter(K_MODS, now);
        } else {
          kPress(kCur.k[0]);
          kEnter(K_DOWN, now);
        }
      }
      break;
    case K_MODS:
      if (kHeld(now, MOD_LEAD_MS)) { kPress(kCur.k[kCur.n - 1]); kEnter(K_DOWN, now); }
      break;
    case K_DOWN:
      if (kHeld(now, KEY_HOLD_MS)) {
        if (kCur.cons) {
          if (kOnUSB) Keyboard.consumerRelease(); else KeyboardBLE.consumerRelease();
          kEnter(K_GAP, now);
        } else if (kCur.n > 1) { kRelease(kCur.k[kCur.n - 1]); kEnter(K_HOLDMODS, now); }
        else            { kReleaseAll();                kEnter(K_GAP, now);  }
      }
      break;
    case K_HOLDMODS:
      // Key is up, modifiers still down. If the next queued chord uses the same
      // modifiers (a fast wheel spin), just tap its key: Control+Option stay down
      // for the whole spin instead of being pressed and released for every step.
      if (!kHeld(now, MOD_TAIL_MS)) break;
      if (qHead != qTail && nextHasSameMods() && (keyQ[qHead].wait == 0 || keyQ[qHead].keep)) {
        if (now - kSince < (keyQ[qHead].wait > KEY_GAP_MS ? keyQ[qHead].wait : KEY_GAP_MS)) break;
        kCur = keyQ[qHead];
        qHead = (qHead + 1) % QLEN;
        kPress(kCur.k[kCur.n - 1]);
        kEnter(K_DOWN, now);
      } else if (qHead != qTail || now - kSince >= MOD_BRIDGE_MS) {
        kReleaseAll();
        kEnter(K_GAP, now);
      }
      break;
    case K_GAP:
      if (kHeld(now, (qHead != qTail && keyQ[qHead].wait > KEY_GAP_MS) ? keyQ[qHead].wait : KEY_GAP_MS)) kState = K_IDLE;
      break;
  }
}

// ═══════════════════════════ AUDIO (non-blocking) ═════════════════
struct Beep { uint16_t f, dur, gap; };
#define BQLEN 12
Beep     beepQ[BQLEN];
uint8_t  bHead = 0, bTail = 0;
uint32_t beepNextAt = 0;

void beep(uint16_t f, uint16_t dur, uint16_t gap = 60) {
  if (!AUDIO_ENABLED) return;
  uint8_t next = (bTail + 1) % BQLEN;
  if (next == bHead) return;
  beepQ[bTail] = { f, dur, gap };
  bTail = next;
}

void serviceAudio(uint32_t now) {
  if (bHead == bTail || (int32_t)(now - beepNextAt) < 0) return;
  Beep &b = beepQ[bHead];
  if (b.f) tone(PIEZO_PIN, b.f, b.dur);
  beepNextAt = now + b.dur + b.gap;
  bHead = (bHead + 1) % BQLEN;
}

void beepMode(Mode m) {                 // 1 beep = VoiceOver, 2 beeps = TD Snap
  int n = (m == MODE_TDSNAP) ? 2 : 1;
  for (int i = 0; i < n; i++) beep(988, 120, 120);
}

// ═══════════════════════════ ACTION → KEYS ════════════════════════
// Option goes down before Control (and both come up together), so the iPad never
// sees Control pressed on its own. Two bare Control taps open Dictation on iPadOS,
// and VoiceOver swallows the arrow key, which made each wheel step look like one.
#define VO KEY_LEFT_ALT, KEY_LEFT_CTRL

void doAction(Action a) {
  if (a == A_NONE) return;
  if (CLICK_ON_ACTION) beep(2000, 8, 0);

  if (currentMode == MODE_VOICEOVER) {
    switch (a) {
      case A_NEXT:    queueKeys(VO, KEY_RIGHT_ARROW); break;
      case A_PREV:    queueKeys(VO, KEY_LEFT_ARROW);  break;
      case A_SELECT:  queueKeys(VO, ' ');             break;
      case A_BACK:    queueKeys(KEY_ESC);             break;
      case A_HOME:    queueKeys(VO, 'h');             break;
      case A_MUTE:    queueKeys(VO, 's'); beep(1319, 50, 0); break;  // chirp confirms the press
      case A_CLOSE_APP:
        // Pause first (media Pause, not the play/pause toggle), so going Home
        // can't push a playing video into Picture in Picture. Then Cmd+W, which
        // closes the app's window (quits it on current iPadOS), then Home as a
        // safety net. If Cmd+W isn't supported by an app, the app is still
        // left paused in the background.
        queueMedia(0, 0x00B1);
        queueKeysEx(400, false, KEY_LEFT_GUI, 'w');
        queueKeysEx(900, false, KEY_LEFT_GUI, 'h');
        break;
      case A_READ:    queueKeys(VO, 'a');             break;
      case A_MAGIC:   queueKeys(VO, '-');             break;
      case A_TAB:     queueKeys(KEY_TAB);             break;
      default: break;
    }
  } else { // MODE_TDSNAP
    switch (a) {
      case A_NEXT:
      case A_PREV:    queueKeys(' ');                 break;  // step scan only moves forward
      case A_SELECT:  queueKeys(KEY_RETURN);          break;
      case A_BACK:    queueKeys(KEY_ESC);             break;
      case A_HOME:    queueKeys(KEY_LEFT_GUI, 'h');   break;
      case A_TAB:     queueKeys(KEY_TAB);             break;
      default: break;                                         // read/magic/mute/close-app: no TD Snap equivalent
    }
  }
}

// ═══════════════════════════ MODE ═════════════════════════════════
void setMode(Mode m, bool announce) {
  currentMode = m;
  encPending = 0;
  EEPROM.write(EEPROM_MODE_ADDR, (uint8_t)m);
  EEPROM.write(EEPROM_MAGIC_ADDR, EEPROM_MAGIC);
  EEPROM.commit();
  if (announce) {
    if (m == MODE_TDSNAP) { beep(660, 90, 30); beep(988, 140, 300); }   // rising
    else                  { beep(988, 90, 30); beep(660, 140, 300); }   // falling
    beepMode(m);
  }
}

// ═══════════════════════════ INPUTS ═══════════════════════════════
bool repeatOK(Btn &b, uint32_t now) {
  return IGNORE_REPEAT_MS == 0 || (now - b.lastFireAt) >= IGNORE_REPEAT_MS || b.lastFireAt == 0;
}

// BACK and CHOOSER act on release, so that starting the BACK + CHOOSER
// mode-switch hold sends nothing. Every other input acts on press.
bool actsOnRelease(uint8_t i) { return i == IN_BACK || i == IN_CHO; }

bool comboDone = false;
bool qnDone = false;

void serviceInputs(uint32_t now) {
  for (uint8_t i = 0; i < NUM_INPUTS; i++) {
    Btn &b = btn[i];
    bool r = (digitalRead(INPUT_PINS[i]) == LOW);
    if (r != b.raw) { b.raw = r; b.rawChangedAt = now; }

    // Debounced edge
    if (b.raw != b.stable && (now - b.rawChangedAt) >= DEBOUNCE_MS) {
      b.stable = b.raw;
      if (b.stable) {                       // press
        b.pressedAt = now; b.fired = false; b.suppressed = false;
      } else if (actsOnRelease(i)) {        // release
        if (!b.suppressed && (now - b.pressedAt) >= HOLD_MS && repeatOK(b, now)) {
          Action a = INPUT_ACTION[currentMode][i];
          doAction(a);
          b.lastFireAt = now;
        }
      }
    }

    if (!b.stable || actsOnRelease(i)) continue;

    if (!b.fired && (now - b.pressedAt) >= HOLD_MS) {
      b.fired = true;
      if (repeatOK(b, now)) {
        doAction(INPUT_ACTION[currentMode][i]);
        b.lastFireAt = now;
      }
    }
  }

  // Mode switch: BACK + CHOOSER both held for MODE_HOLD_MS (timed from the
  // second press). Once both are down together, neither acts on release,
  // even if they're let go early.
  Btn &bk = btn[IN_BACK], &ch = btn[IN_CHO];
  if (bk.stable && ch.stable) {
    bk.suppressed = ch.suppressed = true;
    uint32_t since = (bk.pressedAt > ch.pressedAt) ? bk.pressedAt : ch.pressedAt;
    if (!comboDone && (now - since) >= MODE_HOLD_MS) {
      comboDone = true;
      setMode(currentMode == MODE_VOICEOVER ? MODE_TDSNAP : MODE_VOICEOVER, true);
    }
  } else {
    comboDone = false;
  }

  // Quick Nav toggle: BACK + GREEN both held for MODE_HOLD_MS (VoiceOver mode).
  // Sends Left + Right arrow together, VoiceOver's keyboard command for Quick
  // Nav on/off; VoiceOver says which. Quick Nav can only be switched from a
  // keyboard. (Green still sends Home when it goes down, which is harmless.)
  Btn &gr = btn[IN_GRN];
  if (bk.stable && gr.stable) {
    bk.suppressed = true;
    uint32_t since = (bk.pressedAt > gr.pressedAt) ? bk.pressedAt : gr.pressedAt;
    if (!qnDone && (now - since) >= MODE_HOLD_MS) {
      qnDone = true;
      if (currentMode == MODE_VOICEOVER) { queueKeys(KEY_LEFT_ARROW, KEY_RIGHT_ARROW); beep(880, 60, 40); beep(1175, 60, 0); }
    }
  } else {
    qnDone = false;
  }
}

void serviceEncoder() {
  noInterrupts();
  int32_t c = encCount;
  int32_t steps = c / COUNTS_PER_STEP;          // truncates toward zero
  encCount = c - steps * COUNTS_PER_STEP;
  interrupts();
  if (ENC_REVERSE) steps = -steps;

  if (currentMode == MODE_TDSNAP) encPending += (steps < 0 ? -steps : steps);  // any direction = advance
  else                            encPending += steps;                        // turning back cancels forward
  if (encPending >  ENC_MAX_PENDING) encPending =  ENC_MAX_PENDING;
  if (encPending < -ENC_MAX_PENDING) encPending = -ENC_MAX_PENDING;

  // Release one step only when the keyboard is idle, so nothing piles up behind it.
  if (encPending != 0 && qHead == qTail && (kState == K_IDLE || kState == K_HOLDMODS)) {
    if (encPending > 0) { doAction(A_NEXT); encPending--; }
    else                { doAction(A_PREV); encPending++; }
  }
}

// ═══════════════════════════ SERIAL TEST ══════════════════════════
// For testing from a computer over the same USB cable (the box's USB serial
// port, 115200 baud). One character per command:
//   n / p      wheel one click forward / back
//   s          big select          r g b y c   red green blue yellow chooser
//   e          back (Escape)
//   m          switch mode         ?           print status
//   q          toggle VoiceOver Quick Nav (same as holding Back + Green 3 s)
// Buttons go through the same action table and keyboard path as the real
// switches. An iPad never opens this port, so it has no effect in normal use.
const char* modeName() { return currentMode == MODE_TDSNAP ? "TD Snap" : "VoiceOver"; }

void printStatus() {
  Serial.print("VoiceOver Device firmware " FW_VERSION " | mode: ");
  Serial.print(modeName());
  Serial.print(" | USB keyboard: ");
  if (!tud_mounted())        Serial.print("not connected");
  else if (tud_suspended())  Serial.print("host asleep");
  else if (usbHidReady())    Serial.print("connected, host reading keys");
  else                       Serial.print("connected, host NOT reading keys");
  Serial.print(" | Bluetooth: ");
  Serial.println(PicoBluetoothBLEHID.connected() ? "connected" : "not connected");
}

void serviceSerial() {
  // One command at a time, and only once the previous one has been typed,
  // so a burst like "nps" comes out in order (and n+p don't cancel out).
  while (qHead == qTail && (kState == K_IDLE || kState == K_HOLDMODS) && encPending == 0 && Serial.available() > 0) {
    int c = Serial.read();
    int idx = -1, wheel = 0;
    const char* what = nullptr;
    switch (c) {
      case 'n': wheel = +1; what = "wheel forward"; break;
      case 'p': wheel = -1; what = "wheel back";    break;
      case 's': idx = IN_SEL;  what = "select";  break;
      case 'r': idx = IN_RED;  what = "red";     break;
      case 'g': idx = IN_GRN;  what = "green";   break;
      case 'b': idx = IN_BLU;  what = "blue";    break;
      case 'y': idx = IN_YLW;  what = "yellow";  break;
      case 'c': idx = IN_CHO;  what = "chooser"; break;
      case 'e': idx = IN_BACK; what = "back";    break;
      case 'q':                              // Back + Green hold: toggle Quick Nav
        if (currentMode == MODE_VOICEOVER) queueKeys(KEY_LEFT_ARROW, KEY_RIGHT_ARROW);
        Serial.println("> quick nav toggle");
        return;
      case 'm':
        setMode(currentMode == MODE_VOICEOVER ? MODE_TDSNAP : MODE_VOICEOVER, true);
        Serial.print("> mode now "); Serial.println(modeName());
        continue;
      case '?': printStatus(); continue;
      default: continue;                   // ignore newlines and anything else
    }
    if (wheel) {                           // feed the real wheel decoder
      noInterrupts();
      encCount += (ENC_REVERSE ? -wheel : wheel) * COUNTS_PER_STEP;
      interrupts();
    } else {
      doAction(INPUT_ACTION[currentMode][idx]);
    }
    Serial.print("> "); Serial.println(what);
    break;                                 // next command on a later loop
  }
}

// ═══════════════════════════ LED / BATTERY ════════════════════════
uint32_t ledTimer = 0;
bool     ledOn    = false;

void serviceLED(uint32_t now) {
  if (kState != K_IDLE) return;                   // keypress flash in progress
  uint32_t interval = (currentMode == MODE_TDSNAP) ? 500 : 1000;  // toggles every 0.5 s (TD Snap) or 1 s (VoiceOver)
  if (now - ledTimer >= interval) {
    ledOn = !ledOn; ledTimer = now;
    digitalWrite(LED_BUILTIN, ledOn ? HIGH : LOW);
  }
}

uint32_t battCheckAt = 0, battWarnAt = 0;
void serviceBattery(uint32_t now) {
  if (!BATT_SENSE_ENABLED || now < battCheckAt) return;
  battCheckAt = now + 10000;
  float v = analogRead(BATT_PIN) * (3.3f / 4095.0f) * 2.0f;   // 100k/100k divider
  if (v > 2.5f && v < BATT_LOW_V && now >= battWarnAt) {       // >2.5 V: ignore if unpowered/absent
    beep(440, 200, 120); beep(440, 200, 120); beep(440, 200, 0);
    battWarnAt = now + 60000;
  }
}

// ═══════════════════════════ SETUP / LOOP ═════════════════════════
void setup() {
  for (uint8_t i = 0; i < NUM_INPUTS; i++) {
    pinMode(INPUT_PINS[i], INPUT_PULLUP);
    btn[i] = { false, false, 0, 0, 0, false, false };
  }
  pinMode(ENC_A, INPUT_PULLUP);
  pinMode(ENC_B, INPUT_PULLUP);
  pinMode(LED_BUILTIN, OUTPUT);
  pinMode(PIEZO_PIN, OUTPUT);
  if (BATT_SENSE_ENABLED) analogReadResolution(12);

  encState = ((digitalRead(ENC_A) << 1) | digitalRead(ENC_B));
  attachInterrupt(digitalPinToInterrupt(ENC_A), encISR, CHANGE);
  attachInterrupt(digitalPinToInterrupt(ENC_B), encISR, CHANGE);

  EEPROM.begin(256);
  if (EEPROM.read(EEPROM_MAGIC_ADDR) == EEPROM_MAGIC && EEPROM.read(EEPROM_MODE_ADDR) <= MODE_TDSNAP)
    currentMode = (Mode)EEPROM.read(EEPROM_MODE_ADDR);
  else
    setMode(MODE_VOICEOVER, false);

  Keyboard.begin();
  KeyboardBLE.begin(BLE_NAME);

  // Boot indication: LED flashes 3× (VoiceOver) or 6× (TD Snap) + mode beeps
  int flashes = (currentMode == MODE_TDSNAP) ? 6 : 3;
  for (int i = 0; i < flashes; i++) {
    digitalWrite(LED_BUILTIN, HIGH); delay(100);
    digitalWrite(LED_BUILTIN, LOW);  delay(100);
  }
  beepMode(currentMode);

  rp2040.wdt_begin(8000);   // reboot if loop() ever stops running for 8 s
}

void loop() {
  rp2040.wdt_reset();
  uint32_t now = millis();
  serviceInputs(now);
  serviceSerial();
  serviceEncoder();
  serviceKeys(now);
  serviceAudio(now);
  serviceLED(now);
  serviceBattery(now);
}

!Lid Drill Stencil

PRINT: Click PRINT THIS STENCIL (or Ctrl+P / Cmd+P on this tab) → Letter or A4, Landscape → Scale 100% — do NOT fit to page.
BEFORE DRILLING: Measure the 100mm scale bar. Must be exactly 100mm.
HOLES (as cut on the original box): Encoder = 44mm center + 3× M3 (3.5mm) screws, marked through the encoder itself · Select button = 28mm (M24 thread) · 30mm buttons = 32mm. All flanges sit on top — only the threads go through.

🖶 PRINT THIS STENCIL Prints just the stencil on one page. In the print dialog: Letter or A4, Landscape, scale 100% (not “fit to page”).

!Side Panel Stencil (USB-C connector)

PRINT: Click PRINT THIS STENCIL (or Ctrl+P / Cmd+P on this tab) → Letter or A4, Landscape → Scale 100%.
Mount on the short side (182mm face) of the box, centered, 20mm from bottom.
Internal: USB-C to micro-USB cable runs inside from this connector to the Pico's micro-USB port.

🖶 PRINT THIS STENCIL

8From Breadboard to PCB

A breadboard in a box that gets bumped will eventually lose a wire. Two steps, in order:

1

### Now: solder the prototype onto a Perma-Proto

Adafruit’s Perma-Proto half-size board has the same rows and rails as the 400-point breadboard. Solder the Pico on headers (or sockets), then move each jumper hole-for-hole using the PHYSICAL tab. One evening; same firmware.

2

### Next: the custom carrier board

A small 2-layer board the Pico plugs into, with a keyed JST connector for every button, the encoder, the Red button’s power light, a battery and a power switch. It adds the beeper driver, a LiPo charger and battery monitoring. About 60×80 mm; mounts on four M3 standoffs under the lid.

!What’s on the board

Ref | Part | Connects
J1, J2 | 1×20 sockets | Pico 2 W (socketed, swappable)
J3–J9 | JST-XH 2-pin | Select, Red, Green, Blue, Yellow, Chooser, Back — pin 1 signal, pin 2 GND
J10 | JST-XH 4-pin | Encoder: 1 VCC, 2 GND, 3 A, 4 B
J11 | JST-PH 2-pin | 1S LiPo (check polarity — vendors differ)
J12 | JST-XH 2-pin | Panel power switch (in the battery line)
J13 | 2-pin header | Reset (short to restart)
J14 | JST-XH 2-pin | Red button LED, the power light: pin 1 LED + (VBUS, 5 V), pin 2 LED − (GND)
JP1 | 3-pad solder jumper | Encoder supply: A–C = 3V3 (default), B–C = VSYS

Power: USB powers the Pico as now. A 1S LiPo (J11) charges from USB through an MCP73831 (~210 mA, set by R7) and feeds VSYS through a Schottky diode after the panel switch, alongside the Pico’s own USB diode. A 100k/100k divider after the switch lets the firmware measure the battery (no drain when off).

Encoder: runs from 3V3 by default, which the prototype proves works. If an encoder ever needs 5 V, bridge JP1 B–C and fit R2/R4 (2k) so the 1k/2k divider keeps its outputs at 3.3 V.

Beeper: MMBT3904 low-side switch with a flyback diode, so either a passive piezo or a louder magnetic buzzer works.

!Pin map (matches firmware v10)

Pico pin | GPIO | Net | Goes to
14 | GP10 | ENC_A | Encoder A (via 1k)
15 | GP11 | ENC_B | Encoder B (via 1k)
20 | GP15 | SEL | Big select button
21 | GP16 | RED | Red
22 | GP17 | GRN | Green
24 | GP18 | BLU | Blue
25 | GP19 | YLW | Yellow
26 | GP20 | CHO | Chooser
27 | GP21 | BACK | Back (+ Chooser hold = mode)
29 | GP22 | PIEZO_DRV | Buzzer driver transistor
30 | RUN | RUN | Reset header
31 | GP26 | BATT_SENSE | Battery ÷2 (ADC0)
36 | 3V3 | +3V3 | Encoder (default), buzzer
39 | VSYS | VSYS | Battery in (via Schottky)
40 | VBUS | VBUS | Charger input; Red button power light (J14)

Checked automatically: every GPIO in the netlist matches the firmware’s #defines.

!Make it

1

### Get the files

⬇ voiceover_pcb.net⬇ BOM (.csv)⬇ SKiDL source (.py)

The .py is the source of truth. Edit it and run python3 voiceover_pcb.py out (needs pip install skidl) to regenerate the netlist and BOM. ERC-clean; every footprint is from the stock KiCad library.

2

### Lay out in KiCad 9

1. New project → open the PCB Editor → File → Import → Netlist → pick voiceover_pcb.net.
2. Place J1 and J2 17.78 mm (0.7") apart, centre to centre. J1 pin 1 = Pico pin 1 (USB end). Rotate J2 180° so its pin 1 = Pico pin 21 (the end away from USB).
3. Put the JST connectors along the board edges; keep the Pico’s USB end at the edge facing the side-panel USB-C.
4. Route. 0.5 mm for VSYS/BAT/VBUS, 0.25 mm for signals, ground pour on both layers.
5. Run DRC with JLCPCB’s rules. Print the board 1:1 and lay the Pico on it to check spacing.

3

### Order

1. File → Fabrication Outputs → Gerbers and Drill Files; zip the folder.
2. Upload to JLCPCB or PCBWay: 2 layers, 1.6 mm, HASL. Five boards cost a few dollars plus shipping.
3. All SMD parts are 0805 / SOT-23 / SOD — hand-solderable. Order parts from the BOM (DigiKey, Mouser or LCSC).

4

### Assemble

- Bridge JP1 A–C (3V3). Leave R2, R4 unfitted.
- Check LiPo polarity against J11 before plugging in. Pre-made JST-PH batteries are not consistent.
- Crimp or buy JST-XH pigtails for the panel buttons, the Red LED and the encoder.
- With a battery fitted, set BATT_SENSE_ENABLED true in the firmware.

!Status

Done: netlist, BOM, ERC, footprint names verified, firmware pin cross-check. Not done: board layout, DRC, and a built board. Treat rev 1 as a prototype run.

!Before You Troubleshoot — Quick Checklist

Try these first before anything else. They solve about 80% of problems.

✓ Is the cable plugged into both the box and the iPad, and is the Red button lit? Dark = flip the plug at the box end.

✓ Is VoiceOver turned on on the iPad?

✓ Is the device in the right mode? With VoiceOver on, turn the wheel: items move = VoiceOver mode, nothing happens = TD Snap mode. Hold Back and Chooser together 3 seconds to switch.

✓ Try unplugging and replugging the USB cable. The device restarts automatically.

?Common Problems

Wheel Problems

If

Turning the wheel does nothing at all

Try this

- Check the device is in VoiceOver mode — see the checklist above
- Make sure the cable is fully inserted at both ends and the Red button is lit
- Try a different USB cable — some only charge, they don't carry data

If

Wheel moves through too many items at once — hard to control

Try this

In the sketch, raise COUNTS_PER_STEP from 4 to 8 (one step every two clicks) and re-upload. Keep it a multiple of 4.

If

Wheel moves in the wrong direction — left goes right, right goes left

Try this

Swap the two yellow wires on the encoder screw terminals — swap A and B. Or set ENC_REVERSE true in the sketch and re-upload.

If

Wheel works but is very jumpy or skips randomly

Try this

Check that the yellow encoder wires are firmly seated in their screw terminals. Tighten the screws. Also make sure the encoder is mounted securely in its hole and not wobbling.

Button Problems

If

Big select button does nothing

Try this

- Check the device is in the right mode first
- Check the purple wire is firmly in the breadboard at row 20, col a
- Check the 0.187" clip is fully snapped onto the button's spade terminal

If

A macro button does nothing when pressed

Try this

- Check the 0.11" wire clip is fully snapped onto the button's spade terminal — it should click into place
- Check the other end of the wire is in the correct breadboard row (see wiring table in WIRING tab)
- Make sure the GND wire for that button is also connected to the minus rail

If

Green button doesn't go Home

Try this

This button sends Ctrl+Option+H which is the VoiceOver Home command. Make sure VoiceOver is ON when you press it — it only works while VoiceOver is active.

Connection Problems

If

The iPad doesn’t react to the box at all

Try this

- Red button dark: flip the plug at the box end (the box’s USB-C port only works one way up)
- Red button lit: try a different cable — many USB-C cables only charge
- Check Settings → Privacy & Security → Wired Accessories, and unplug, unlock the iPad, and plug in again
- Restart the iPad and try again

If

Device worked before but suddenly stopped

Try this

- Unplug and replug the USB cable — the Pico restarts and reconnects
- Check if a wire has come loose from the breadboard — press each wire firmly into its hole
- Check if a quick-connect clip has come off a button terminal

If

Device works on one iPad or iPhone but not another

Try this

Each device needs its own setup (iPHONE/iPAD tab): VoiceOver on, Control + Option in Modifier Keys, Full Keyboard Access off, Wired Accessories allowed. These settings don’t transfer between devices. Lightning iPhones need Apple’s Lightning to USB Camera Adapter.

Firmware v10

If

Every action happens twice

Try this

You have v9 or older firmware with both USB and Bluetooth connected to the same iPad. Install v10 (FIRMWARE tab) — it sends over USB only when plugged in.

If

With VoiceOver on, the wheel does nothing and only Chooser (or the big button) seems to do anything

Try this

The device is in TD Snap mode. It sends Space, Enter and Tab instead of VoiceOver commands, and VoiceOver ignores most of them. With the lid off, the Pico’s LED blinks twice as fast in TD Snap mode. Hold Back and Chooser together for 3 seconds to switch back. The mode survives unplugging, so a box left in TD Snap mode stays that way.

If

VoiceOver ignores the box on an iPad (the wheel does nothing, or turning it opens Dictation), but it works on a Mac

Try this

Install v10.5 or later. Older firmware pressed Control, Option and the key within a few milliseconds and let go of everything at once; an iPad saw the key held for only 1–3 ms and VoiceOver ignored it, treating the Control presses as plain taps (two quick taps open Dictation). v10.5 presses Control + Option first, holds the key 60 ms, and releases the modifiers last. Also check Settings → Accessibility → VoiceOver → Typing → Modifier Keys includes Control + Option.

If

Spinning the wheel quickly opens Dictation on the iPad

Try this

Install v10.6 or later. VoiceOver swallows the arrow key, so the iPad saw each wheel step as a bare Control tap, and two quick Control taps are the Dictation shortcut. v10.6 presses Option before Control and keeps both held through a fast spin. You can also turn off the Control-twice Dictation shortcut in Settings → General → Keyboard.

If

Red button doesn’t light when plugged in

Try this

The box has no power. The USB-C port on the box only passes power one way round: flip the plug at the box end. If it still stays dark, try another cable. Red lit but nothing happens on the iPad: the cable may be charge-only, or the iPad is blocking the accessory (Settings → Privacy & Security → Wired Accessories).

If

Going Home leaves Netflix or Apple TV playing

Try this

That is Picture in Picture: the video shrinks into a floating window and keeps playing. Turn it off in Settings → General → Picture in Picture → Start PiP Automatically. Press Yellow (play/pause) before Home, or press Chooser to close the app completely.

If

Chooser doesn’t close the app

Try this

Chooser sends the media Pause key, then Command + W (closes the app’s window), then Home. It takes under 2 seconds. If an app ignores Command + W it is still left paused in the background, not playing. If video still floats in Picture in Picture, turn off Start PiP Automatically (above).

If

Check what the device is doing, from a computer

Try this

Plug it into a Mac or PC, open the Arduino IDE, pick the Pico’s port, and open Tools → Serial Monitor. Type ? and press Return. It reports the firmware version, the mode, whether a USB host is reading its keys, and whether Bluetooth is connected. You can also press buttons from here, one letter each: n/p wheel forward/back, s select, r g b y c red green blue yellow chooser, e back, m switch mode, q toggle Quick Nav. The keystrokes go to whatever app is in front, through the same path as the real buttons. An iPad never opens this port, so it has no effect in normal use.

If

Wheel works but buttons that used to work don’t (or vice versa) after updating

Try this

v10 changed several buttons — see the table in HOW IT WORKS. Red is now “read from here”, Blue mutes/unmutes VoiceOver, Yellow is Magic Tap, and Back and Chooser act when released. Since v10.4 the mode switch is Back + Chooser held together for 3 seconds; holding Back alone just sends Back.

If

Accidental double presses or presses from brushing a button

Try this

Raise IGNORE_REPEAT_MS (double presses) or HOLD_MS (brushes) at the top of the sketch and re-upload. Start at 300 and 150.

If

Wheel steps feel uneven, or go the wrong way

Try this

COUNTS_PER_STEP should be a multiple of 4. Set ENC_REVERSE true to flip direction.

If

Bluetooth shows “PicoW BLE Keyboard”

Try this

iOS cached the old name. Forget the device, Bluetooth off, power-cycle the device, Bluetooth on, re-pair. See FIRMWARE step G.

If

VoiceOver talks over a video or game

Try this

Press Blue to mute it (VO+S). Press Blue again to unmute. VoiceOver stays on the whole time.

VoiceOver Behavior

If

VoiceOver speaks too fast to understand

Try this

Settings → Accessibility → VoiceOver → Speech → Speaking Rate — drag the slider to the left to slow it down.

If

VoiceOver announces too much extra information with every item

Try this

Settings → Accessibility → VoiceOver → Verbosity — reduce what gets announced. Start by turning off "Punctuation" and "Hints".

If

VoiceOver is on but the student can't navigate to a specific app

Try this

Press the green button first to make sure you're on the Home screen. Then use the wheel to navigate to the app icon and press the big button to open it. If the iPad is locked, navigate to the Lock Screen and press the big button to begin unlocking.

When Nothing Else Works

If

Everything seems broken and you don't know where to start

Try this — in order

- 1. Unplug the USB cable, wait 10 seconds, plug back in
- 2. Make sure VoiceOver is on in the iPad’s Settings and the Red button is lit
- 3. Check the mode: with VoiceOver on, the wheel should move between items
- 4. Open the box and gently press all wires firmly into the breadboard
- 5. Try a completely different USB cable
- 6. Restart the iPad
