wmetcalf/voiceover-switch-box/(commit log)

2026-11-10 Initial open-source release: VoiceOver Switch Box v10.10
    Pico 2 W large-button controller that drives iPad VoiceOver and TD Snap
    switch scanning over USB or Bluetooth. Firmware v10.10, prebuilt UF2,
    desktop simulator (44 scenarios), parts list, wiring, iPad setup
    checklist, illustrated build guide, key-check web page, and an untested
    optional carrier PCB netlist. MIT licensed.
    Claude-Session: https://claude.ai/code/session_016EgxfpGeAhaW11oNg5y9FD
    [voiceover_pcb_bom.csv]
2026-11-10 Link the build guide and Box Key Check page on GitHub Pages
    GitHub shows .html files as source, so point the README, wiring notes and
    iPad checklist at the Pages copies, and add .nojekyll so Pages serves the
    files as-is.
    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
2026-11-10 CI: keep the gh-pages branch in step with main
    GitHub Pages serves the gh-pages branch, which carries the build guide and
    the Box Key Check page. After the simulator and firmware build pass on
    main, CI pushes main to gh-pages so the published pages stay current.
    CI itself no longer runs on gh-pages pushes.
    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
2026-11-10 Docs: fixes from a full re-review
    - Parts: one pack of 0.11" quick-connect pairs is enough (7 used); add the
    encoder's M3 screws; drop an unverified alternate encoder part number.
    - Guide: encoder ground comes from the left - rail in the wire table, as in
    the diagram; lid screw count no longer assumed.
    - iPad setup: Green returns to the first Home Screen page only when pressed
    again on the Home Screen.
    - README: CI also publishes main to GitHub Pages.
    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
2026-11-10 Firmware v10.11: remove unused spare inputs and dead actions
    No change in behaviour for a built box. Removes the four spare switch
    inputs on GP2-GP5 (never wired), the actions no button used any more
    (item chooser, page turning, a bare Control tap), and the serial test
    port's 1-4 commands. Simulator, keytest, prebuilt UF2, changelog and
    build guide updated to match.
    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
2026-11-10 Docs: the built box has no beeper
    Take the piezo and its beeps out of the parts list, wiring table, iPad
    checklist and build guide. The mode is checked by turning the wheel with
    VoiceOver on. The optional PCB keeps its buzzer driver and the firmware
    still drives GP22, which is harmless with nothing connected.
    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
2026-11-10 Add a printable button card
    One Letter page showing the box and what each control does in VoiceOver
    mode, with the two-button holds and the TD Snap mapping. Linked from the
    README.
    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
2026-11-10 Guide: the print button prints the whole guide
    PRINT GUIDE only printed the tab on screen, in light text on white. It
    now prints every tab except the stencils, with all 14 wire steps expanded,
    the diagrams drawn and dark-on-white print colours. The firmware listing
    is left out of the printout.
    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
